gugray/InterGalacticReceiver/docs/call-for-aliens/10-igr-calibrating.jpg

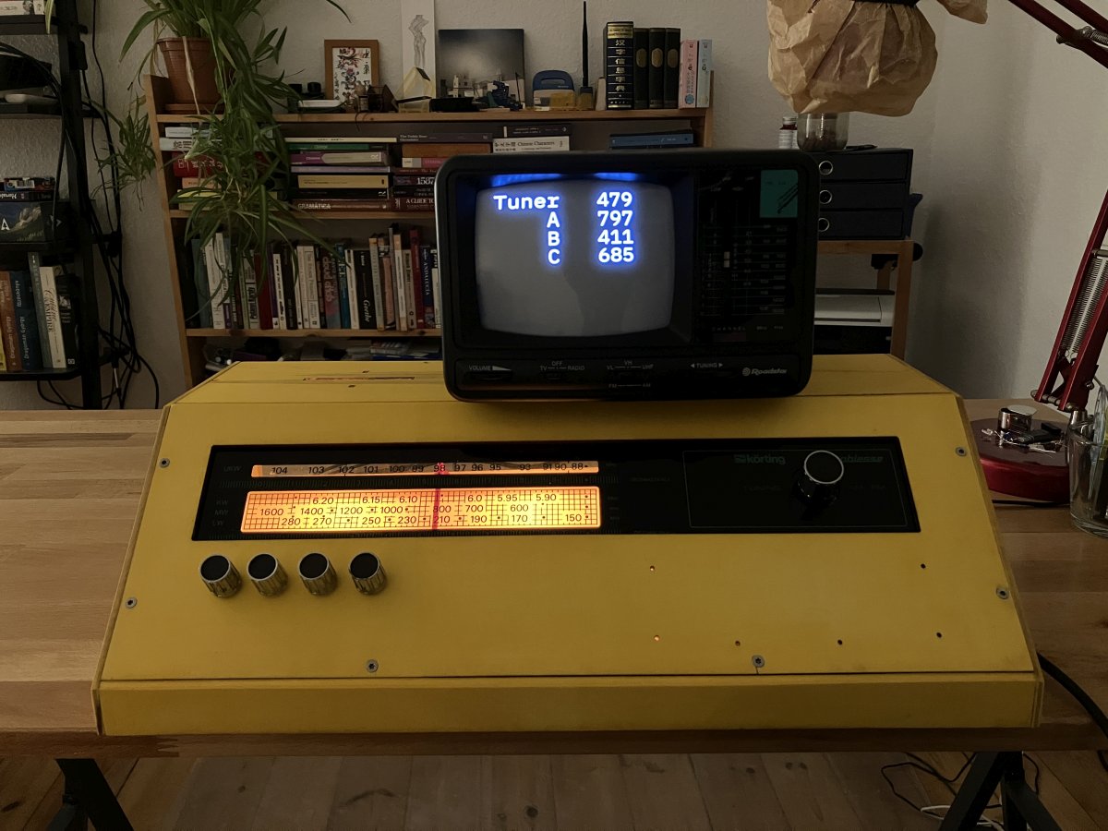
docs/call-for-aliens/10-igr-calibrating.jpg
