gugray/InterGalacticReceiver/docs/call-for-aliens/20-igr-rear-view.jpg

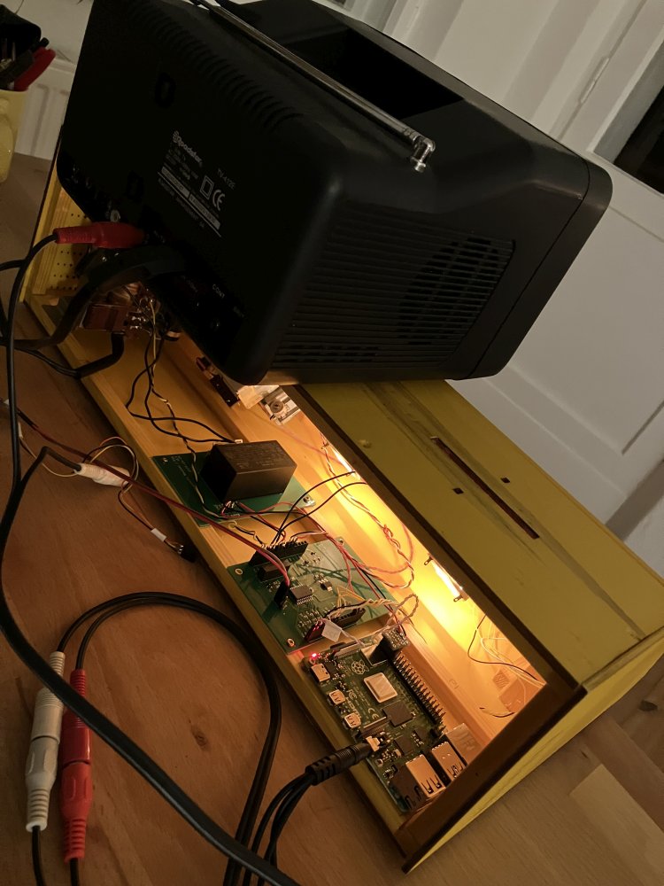
docs/call-for-aliens/20-igr-rear-view.jpg
