gugray/InterGalacticReceiver/docs/notes.txt

Misc TO-DO:
-- Document code for shader contributors

SW TO-DO:
OK Fix LED behavior in MCU
OK Fix frequency jumps (I2C checksum)
OK Fix static noise (over time)
OK Do not render hidden shader; only init sketch
-- Info overlay
-- Add Kazik broadcast

Learnings
-- Wildly swinging tuner readings: 10uF cap fixes it
