gugray/InterGalacticReceiver/docs/call-for-aliens/00-igr-antenna-fitting.jpg

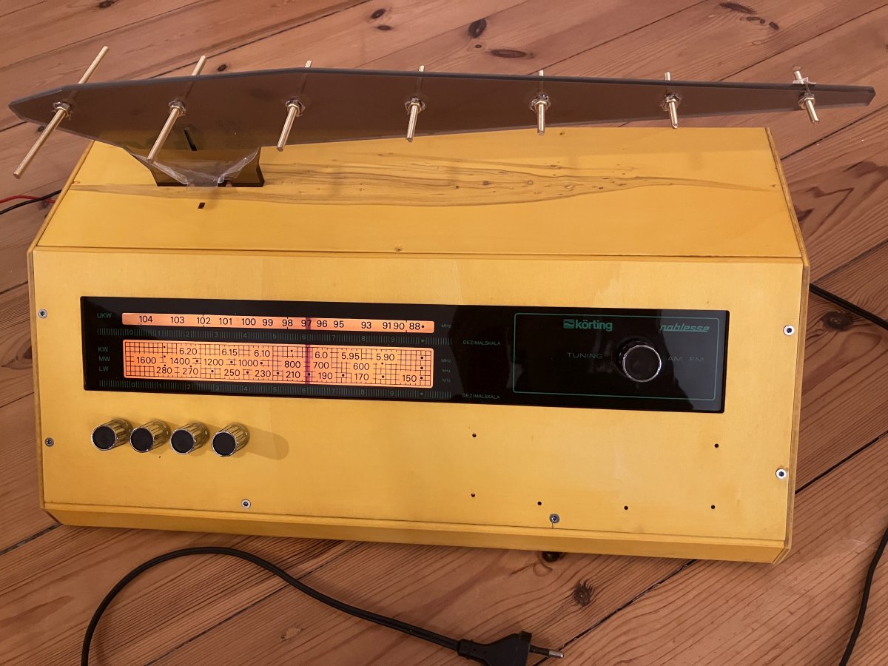
docs/call-for-aliens/00-igr-antenna-fitting.jpg
