gugray/InterGalacticReceiver/electronics/power/power.kicad_pcb

## KiCad design electronics/power/power.kicad_pcb (2025-10-29)

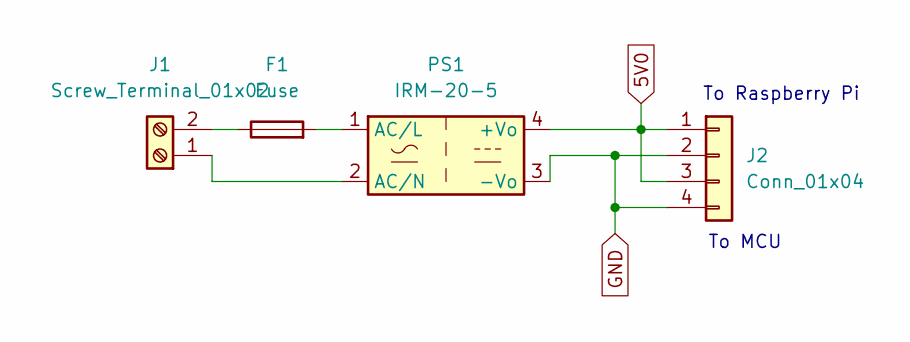
[picture p4: schematic power.kicad_sch]

Parts:
F1: Fuse; FuseSocket
J1: Screw_Terminal_01x02; TerminalBlock_4Ucon_1x02_P3.50mm_Horizontal
J2: Conn_01x04; PinHeader_1x04_P2.54mm_Vertical
PS1: IRM-20-5; Converter_ACDC_MeanWell_IRM-20-xx_THT

Connections:
5V0: J2.1, J2.3, PS1.4 (+Vo)
GND: J2.2, J2.4, PS1.3 (-Vo)
unnamed: J1.1, PS1.2 (AC/N)
unnamed: F1.1, J1.2
unnamed: F1.2, PS1.1 (AC/L)

Notes on the sheet:
To MCU
To Raspberry Pi

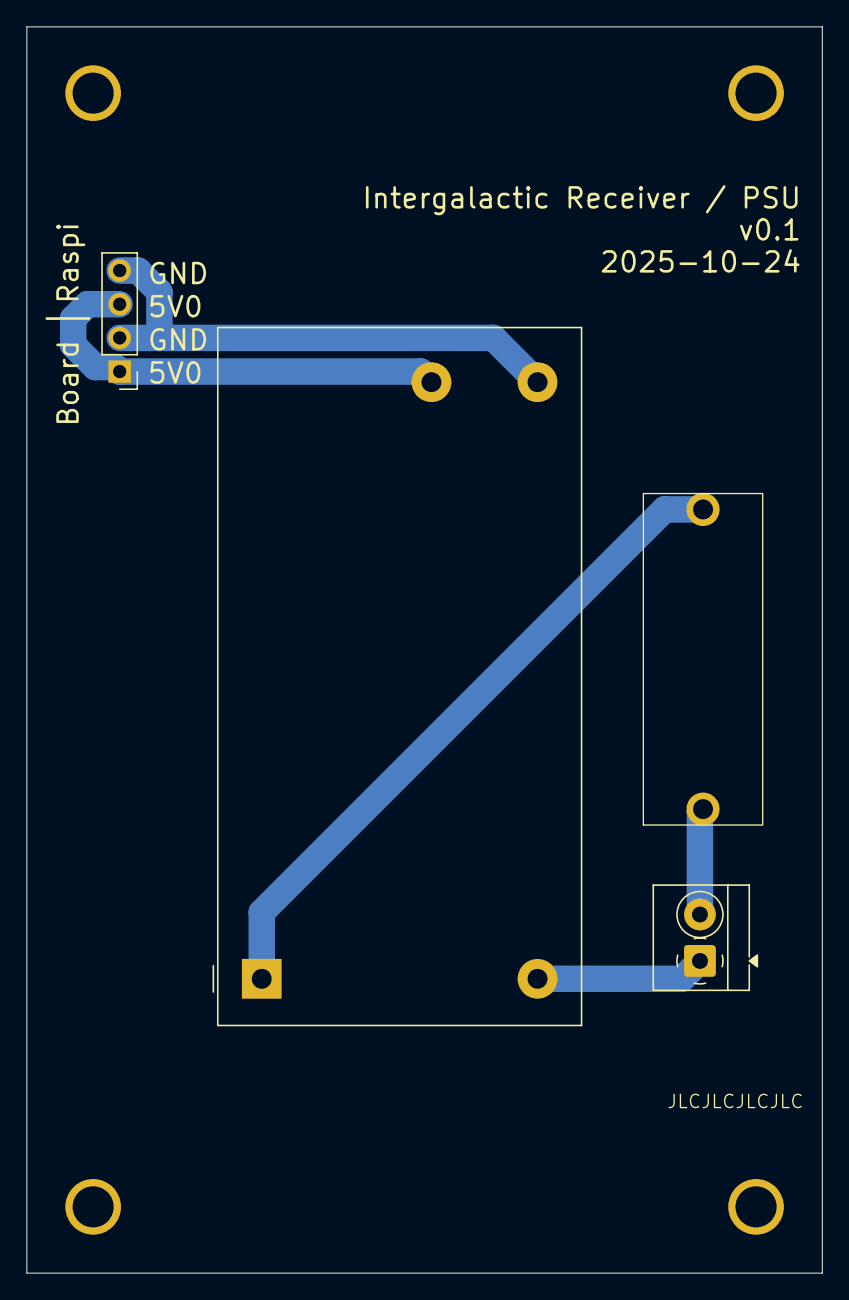
[picture p5: board power.kicad_pcb from above]

Board: 2 copper layers, 60.0 x 94.0 mm, 4 parts (0 on the bottom side), 5 nets.
