gugray/InterGalacticReceiver/electronics/mcu/mcu.kicad_pcb

## KiCad design electronics/mcu/mcu.kicad_pcb (2025-10-29)

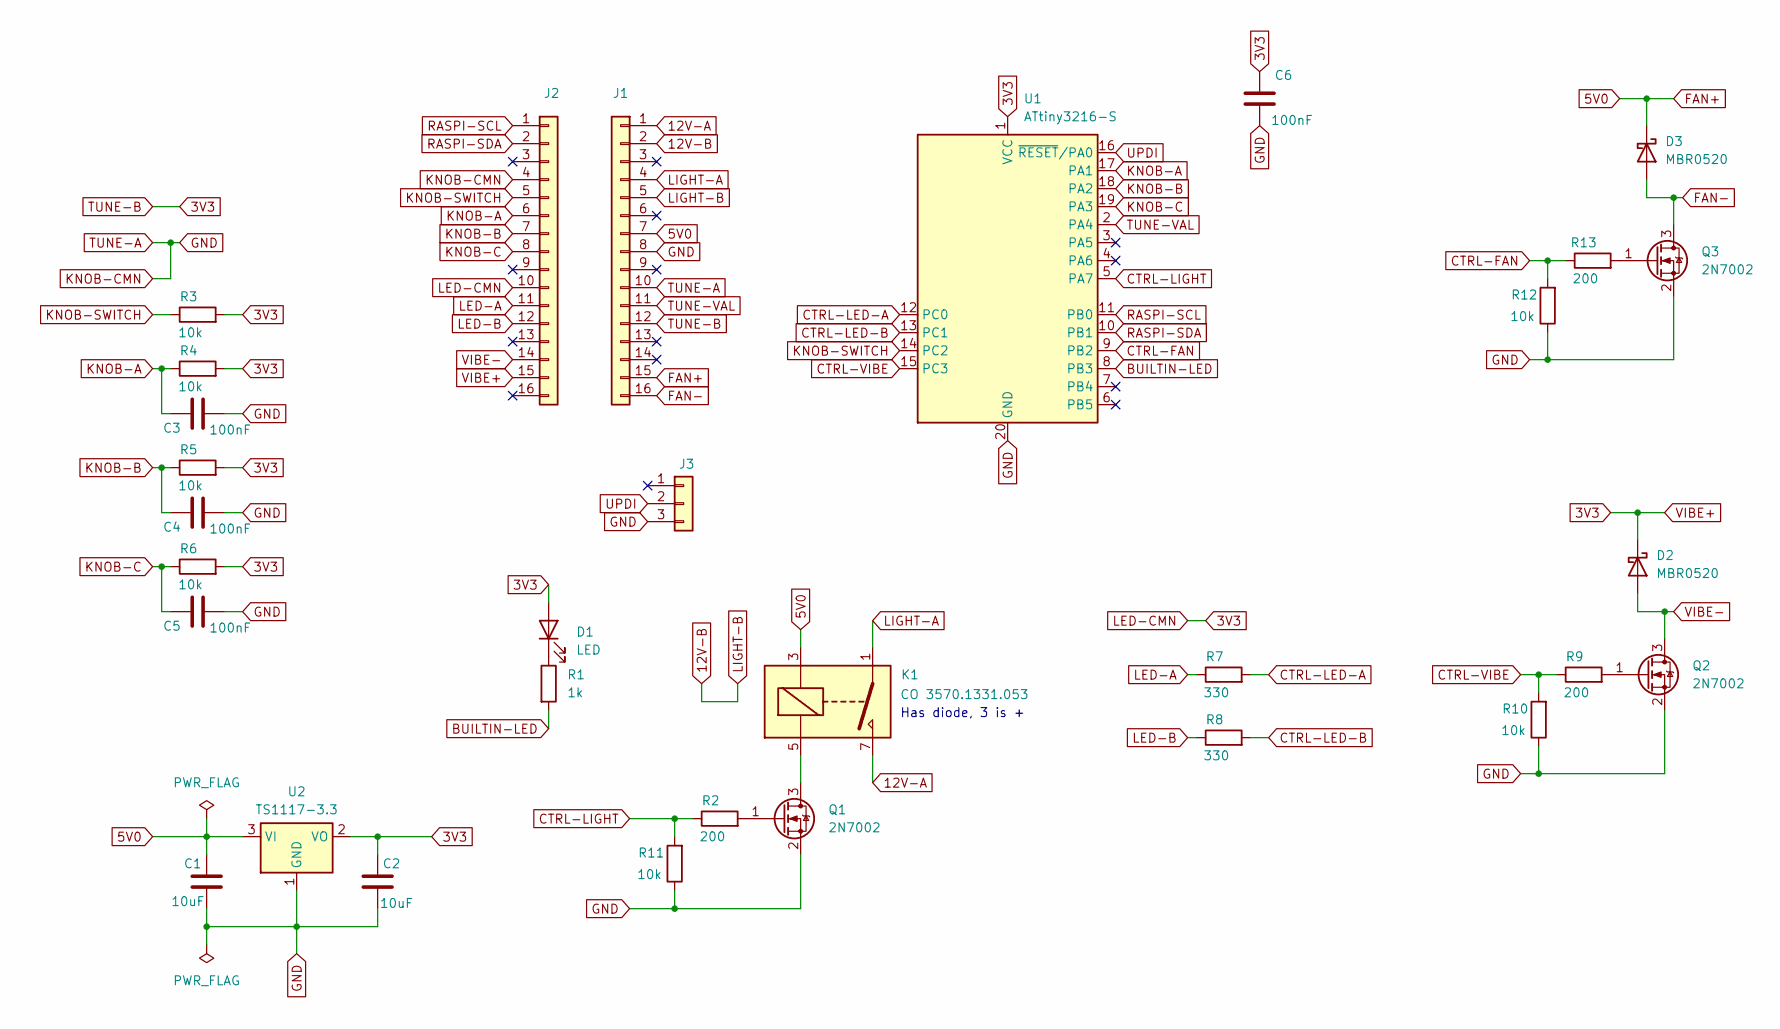
[picture p6: schematic mcu.kicad_sch]

Parts:
C1, C2: 10uF; C_0805_2012Metric
C3, C4, C5, C6: 100nF; C_0805_2012Metric
D1: LED; LED_0805_2012Metric
D2, D3: MBR0520; D_SOD-123
J1, J2: Conn_01x16; PinSocket_1x16_P2.54mm_Vertical
J3: Conn_01x03; PinHeader_1x03_P2.54mm_Vertical
K1: CO 3570.1331.053; Relay_SPST_StandexMeder_SIL_Form1A
Q1, Q2, Q3: 2N7002; SOT-23
R1: 1k; C_0805_2012Metric
R2, R9, R13: 200; C_0805_2012Metric
R3, R4, R5, R6, R10, R11, R12: 10k; C_0805_2012Metric
R7, R8: 330; C_0805_2012Metric
U1: ATtiny3216-S; SOIC-20W_7.5x12.8mm_P1.27mm
U2: TS1117-3.3; SOT-223-3_TabPin2

Connections:
3V3: C2.1, C6.1, D1.2 (A), D2.1 (K), J1.12, J2.10, J2.15, R3.2, R4.2, R5.2, R6.2, U1.1 (VCC), U2.2 (VO)
5V0: C1.1, D3.1 (K), J1.7, J1.15, K1.3, U2.3 (VI)
12V-A: J1.1, K1.7
12V-B: J1.2, J1.5
BUILTIN-LED: R1.2, U1.8 (PB3)
CTRL-FAN: R12.2, R13.1, U1.9 (PB2)
CTRL-LED-A: R7.2, U1.12 (PC0)
CTRL-LED-B: R8.2, U1.13 (PC1)
CTRL-LIGHT: R2.1, R11.2, U1.5 (PA7)
CTRL-VIBE: R9.1, R10.2, U1.15 (PC3)
FAN-: D3.2 (A), J1.16, Q3.3 (D)
GND: C1.2, C2.2, C3.2, C4.2, C5.2, C6.2, J1.8, J1.10, J2.4, J3.3, Q1.2 (S), Q2.2 (S), Q3.2 (S), R10.1, R11.1, R12.1, U1.20 (GND), U2.1 (GND)
KNOB-A: C3.1, J2.6, R4.1, U1.17 (PA1)
KNOB-B: C4.1, J2.7, R5.1, U1.18 (PA2)
KNOB-C: C5.1, J2.8, R6.1, U1.19 (PA3)
KNOB-SWITCH: J2.5, R3.1, U1.14 (PC2)
LED-A: J2.11, R7.1
LED-B: J2.12, R8.1
LIGHT-A: J1.4, K1.1
unnamed: D1.1 (K), R1.1
unnamed: K1.5, Q1.3 (D)
unnamed: Q1.1 (G), R2.2
unnamed: Q2.1 (G), R9.2
unnamed: Q3.1 (G), R13.2
RASPI-SCL: J2.1, U1.11 (PB0)
RASPI-SDA: J2.2, U1.10 (PB1)
TUNE-VAL: J1.11, U1.2 (PA4)
UPDI: J3.2, U1.16 (~RESET/PA0)
VIBE-: D2.2 (A), J2.14, Q2.3 (D)

Notes on the sheet:
Has diode, 3 is +

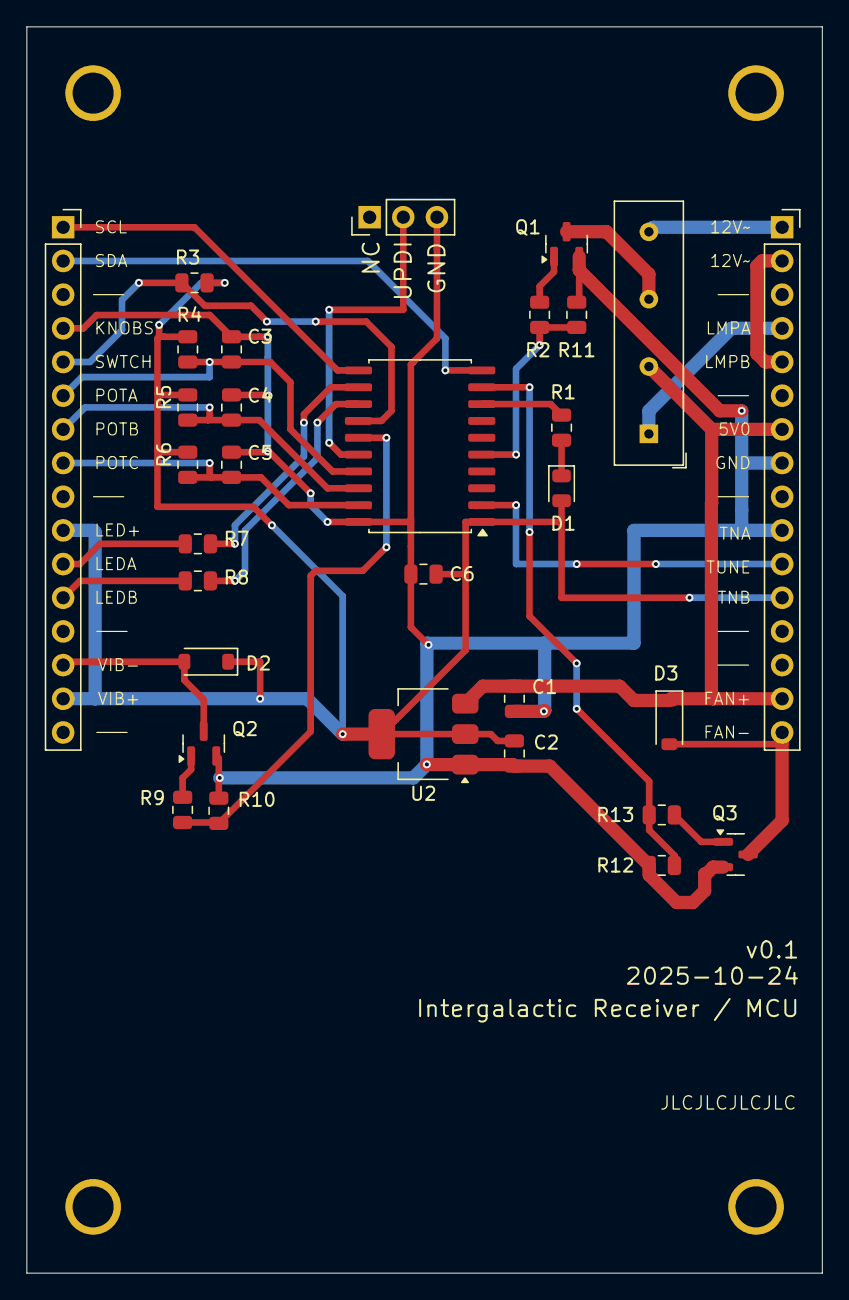
[picture p7: board mcu.kicad_pcb from above]

Board: 2 copper layers, 60.0 x 94.0 mm, 31 parts (0 on the bottom side), 29 nets.
