gugray/InterGalacticReceiver/electronics/raspiconn/raspiconn.kicad_pcb

## KiCad design electronics/raspiconn/raspiconn.kicad_pcb (2025-10-29)

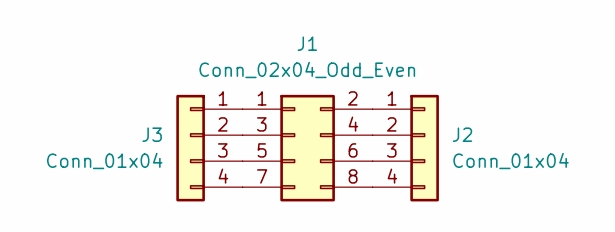
[picture p8: schematic raspiconn.kicad_sch]

Parts:
J1: Conn_02x04_Odd_Even; PinSocket_2x04_P2.54mm_Vertical
J2, J3: Conn_01x04; PinHeader_1x04_P2.54mm_Vertical

Connections:
unnamed: J1.1, J3.1
unnamed: J1.2, J2.1
unnamed: J1.3, J3.2
unnamed: J1.4, J2.2
unnamed: J1.5, J3.3
unnamed: J1.6, J2.3
unnamed: J1.7, J3.4
unnamed: J1.8, J2.4

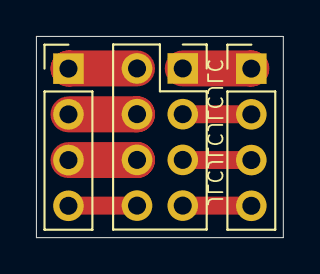
[picture p9: board raspiconn.kicad_pcb from above]

Board: 2 copper layers, 13.7 x 11.2 mm, 3 parts (0 on the bottom side), 8 nets.
