gugray/InterGalacticReceiver/code-raspi/src/render_blender.cpp

#include "render_blender.h"

// Local dependencies
#include "error.h"
#include "horrors.h"
#include "magic.h"
#include "sketches/shaders.h"
#include "sketches/sketch_base.h"

// Global
#include <stdlib.h>

RenderBlender::RenderBlender()
{
    SketchBase::create_target_texture(W, H, render_tex, render_fbo, render_depth);
    compile_render_prog();
    overlay_tex = SketchBase::create_texture(nullptr, W, H);
}

void RenderBlender::render(double time)
{
    glUseProgram(render_prog);

    glBindBuffer(GL_ARRAY_BUFFER, render_vbo);
    glEnableVertexAttribArray(0);
    glVertexAttribPointer(0, 2, GL_FLOAT, GL_FALSE, 0, 0);

    glActiveTexture(GL_TEXTURE0);
    glBindTexture(GL_TEXTURE_2D, render_tex);

    glActiveTexture(GL_TEXTURE1);
    glBindTexture(GL_TEXTURE_2D, overlay_tex);

    GLint tex_sketch_loc = glGetUniformLocation(render_prog, "texSketch");
    GLint tex_overlay_loc = glGetUniformLocation(render_prog, "texOverlay");
    GLint resolution_loc = glGetUniformLocation(render_prog, "resolution");
    GLint time_loc = glGetUniformLocation(render_prog, "time");
    GLint rand_loc = glGetUniformLocation(render_prog, "rand");
    GLint blend_mode_loc = glGetUniformLocation(render_prog, "blendMode");

    glUniform1i(tex_sketch_loc, 0);
    glUniform1i(tex_overlay_loc, 1);
    glUniform2f(resolution_loc, (float)W, (float)H);
    glUniform1f(time_loc, (float)time);
    glUniform1f(rand_loc, (float)((double)rand() / RAND_MAX));

    int blendMode = 0; // static
    if (mode == bmInfo) blendMode = 1;
    else if (mode == bmSketch) blendMode = 2;
    glUniform1i(blend_mode_loc, blendMode);

    glBindFramebuffer(GL_FRAMEBUFFER, 0);
    glViewport(0, 0, W, H);
    glClearColor(0, 0, 0, 1);
    glClear(GL_COLOR_BUFFER_BIT | GL_DEPTH_BUFFER_BIT);
    glDrawArrays(GL_TRIANGLES, 0, 6);
    glFinish();
}

void RenderBlender::compile_render_prog()
{
    // Compile shaders
    auto vs = SketchBase::compile_shader(GL_VERTEX_SHADER, sweep_vert);
    auto fs = SketchBase::compile_shader(GL_FRAGMENT_SHADER, render_frag);

    // Link program, with position attribute
    render_prog = glCreateProgram();
    glAttachShader(render_prog, vs);
    glAttachShader(render_prog, fs);
    const GLint ixPosAttribute = 0;
    glBindAttribLocation(render_prog, ixPosAttribute, "position");
    glLinkProgram(render_prog);
    GLint ok = 0;
    glGetProgramiv(render_prog, GL_LINK_STATUS, &ok);
    if (!ok) SketchBase::throw_shader_link_error(render_prog);

    // Array buffer: for vertex array
    std::vector<GLfloat> quad;
    SketchBase::fill_quad(quad);

    glGenBuffers(1, &render_vbo);
    glBindBuffer(GL_ARRAY_BUFFER, render_vbo);
    glBufferData(GL_ARRAY_BUFFER, sizeof(GLfloat) * quad.size(), &quad[0], GL_STATIC_DRAW);
}

void RenderBlender::set_mode(BlendMode mode)
{
    this->mode = mode;
}

void RenderBlender::set_overlay(const uint8_t *px_data)
{
    glBindTexture(GL_TEXTURE_2D, overlay_tex);
    glPixelStorei(GL_UNPACK_ALIGNMENT, 1);
    glTexSubImage2D(GL_TEXTURE_2D, 0, 0, 0, W, H, GL_RGBA, GL_UNSIGNED_BYTE, px_data);
}
