gugray/InterGalacticReceiver/(commit log)

2025-10-29 initial commit / wip
    [mcu.kicad_pcb, mcu.kicad_sch, power.kicad_pcb, power.kicad_sch, raspiconn.kicad_pcb, raspiconn.kicad_sch, tuner.kicad_pcb, tuner.kicad_sch]
2025-11-03 i2c wip
2025-11-21 i2c hardware controller in dedicated file with bg thread
2026-03-02 Revert "make work on linux"
    This reverts commit de673e6c017a8106eed1d8b97fcb2d1416e7523c.
    # Conflicts:
    # code-raspi/src/horrors.cpp
    [hardware_controller.cpp, hardware_controller.h, horrors.cpp, horrors.h, main.cpp]
2026-03-02 LED behavior tweaks in MCU
2026-03-02 backlight not controlled by main switch; off command
2026-03-02 fix static with random uniform
    [render_blender.cpp, shaders.h]
